TomNisbet/nqsap/docs/support/10-in-summary.md

---
title: "NQSAP and 6502 Instructions"
permalink: /docs/in-summary/
excerpt: "Instruction set summary for the NQSAP Computer"
---

## Instructions Common to 6502 and NQSAP

|Name|Description|Flags|
|:---|:---|:---:|
|[ADC](../in-details#ADC)|Add with Carry|CZVN|
|[AND](../in-details#AND)|Logical AND|-Z-N|
|[ASL](../in-details#ASL)<sub>1</sub>|Arithmetic Shift Left|CZ-N|
|[BCC](../in-details#BCC)|Branch if Carry Clear|----|
|[BCS](../in-details#BCS)|Branch if Carry Set|----|
|[BEQ](../in-details#BEQ)|Branch if Equal|----|
|[BIT](../in-details#BIT)<sub>2</sub>|Bit Test|-Z--|
|[BMI](../in-details#BMI)<sub>3</sub>|Branch if Minus|----|
|[BNE](../in-details#BNE)|Branch if Not Equal|----|
|[BPL](../in-details#BPL)<sub>3</sub>|Branch if Positive|----|
|[BVC](../in-details#BVC)<sub>3</sub>|Branch if Overflow Clear|----|
|[BVS](../in-details#BVS)<sub>3</sub>|Branch if Overflow Set|----|
|[CLC](../in-details#CLC)<sub>3</sub>|Clear Carry|C---|
|[CLV](../in-details#CLV)<sub>3</sub>|Clear Overflow|--V-|
|[CMP](../in-details#CMP)<sub>4</sub>|Compare A|CZVN|
|[CPX](../in-details#CPX)<sub>4</sub>|Compare X|CZVN|
|[CPY](../in-details#CPY)<sub>4</sub>|Compare Y|CZVN|
|[DEC](../in-details#DEC)|Decrement Memory|-Z-N|
|[DEX](../in-details#DEX)|Decrement X|-Z-N|
|[DEY](../in-details#DEY)|Decrement Y|-Z-N|
|[EOR](../in-details#EOR)|Exclusive OR|-Z-N|
|[INC](../in-details#INC)|Increment Memory|-Z-N|
|[INX](../in-details#INX)|Increment X|-Z-N|
|[INY](../in-details#INY)|Increment Y|-Z-N|
|[JMP](../in-details#JMP)|Jump|----|
|[JSR](../in-details#JSR)|Jump to Subroutine|----|
|[LDA](../in-details#LDA)|Load A|----|
|[LDX](../in-details#LDX)|Load X|----|
|[LDY](../in-details#LDY)|Load Y|----|
|[LSR](../in-details#LSR)<sub>5</sub>|Logical Shift Right|CZ-N|
|[NOP](../in-details#NOP)|No Operation|----|
|[ORA](../in-details#ORA)|Logical Inclusive OR|-Z-N|
|[PHA](../in-details#PHA)|Push A|----|
|[PLA](../in-details#PLA)|Pull A|----|
|[ROL](../in-details#ROL)<sub>5</sub>|Rotate Left|CZ-N|
|[ROR](../in-details#ROR)<sub>5</sub>|Rotate Right|CZ-N|
|[RTS](../in-details#RTS)|Return from Subroutine|----|
|[SBC](../in-details#SBC)|Subtract with Carry|CZVN|
|[SEC](../in-details#SEC)|Set Carry|C---|
|[STA](../in-details#STA)|Store A|----|
|[STX](../in-details#STX)|Store X|----|
|[STY](../in-details#STY)|Store Y|----|
|[TAX](../in-details#TAX)|Transfer A to X|----|
|[TAY](../in-details#TAY)|Transfer A to Y|----|
|[TSX](../in-details#TSX)|Transfer SP to X|----|
|[TXA](../in-details#TXA)|Transfer X to A|----|
|[TXS](../in-details#TXS)|Transfer X to SP|----|
|[TYA](../in-details#TYA)|Transfer Y to A|----|

**Notes:**
1. Does not set C flag.  Will be fixed in flags redesign
1. Does not set V and N flags
1. Requires V and N flags and ability to update, set, and clear individual flags. Redesign in progress to replace flags register with D flip-flops
1. Need to share ALU opcode with the SBC operation.  Redesign in progress to override IR and force ALU into subtract mode
1. Requires new A register hardware
## 6502 Instructions Not Implemented in NQSAP

|Name|Description|Flags|
|:---|:---|:---:|
|[BRK](../in-details#BRK)<sub>1</sub>|Force Interrupt|----|
|[CLD](../in-details#CLD)<sub>2</sub>|Clear Decimal Mode|----|
|[CLI](../in-details#CLI)<sub>1</sub>|Clear Interrupt Disable|----|
|[PHP](../in-details#PHP)<sub>3</sub>|Push Processor Status|----|
|[PLP](../in-details#PLP)<sub>3</sub>|Pull Processor Status|----|
|[RTI](../in-details#RTI)<sub>1</sub>|Return from Interrupt|----|
|[SED](../in-details#SED)<sub>2</sub>|Set Decimal Mode|----|
|[SEI](../in-details#SEI)<sub>1</sub>|Set interrupt Disable|----|

**Notes:**
1. No support for interrupts
1. No support for decimal mode
1. Flags register does not have access to the bus
## NQSAP Extensions

|Name|Description|Flags|
|:---|:---|:---:|
|[DEA](../in-details#DEA)|Decrement A|-Z-N|
|[HLT](../in-details#HLT)|Halt|----|
|[INA](../in-details#INA)|Increment A|-Z-N|
|[JCC](../in-details#JCC)|Jump if Carry Clear|----|
|[JCS](../in-details#JCS)|Jump if Carry Set|----|
|[JEQ](../in-details#JEQ)|Jump if Equal|----|
|[JMI](../in-details#JMI)|Jump if Minus|----|
|[JNE](../in-details#JNE)|Jump if Not Equal|----|
|[JPL](../in-details#JPL)|Jump if Positive|----|
|[JVC](../in-details#JVC)|Jump if Overflow Clear|----|
|[JVS](../in-details#JVS)|Jump if Overflow Set|----|
|[NOT](../in-details#NOT)|Bitwise NOT A|-Z-N|
|[OUT](../in-details#OUT)|Output A|----|

*this file was generated by nqsap-instructions.py at 22-Nov-2020 13:09:39*
