TomNisbet/nqsap/docs/assets/images/demo.gif

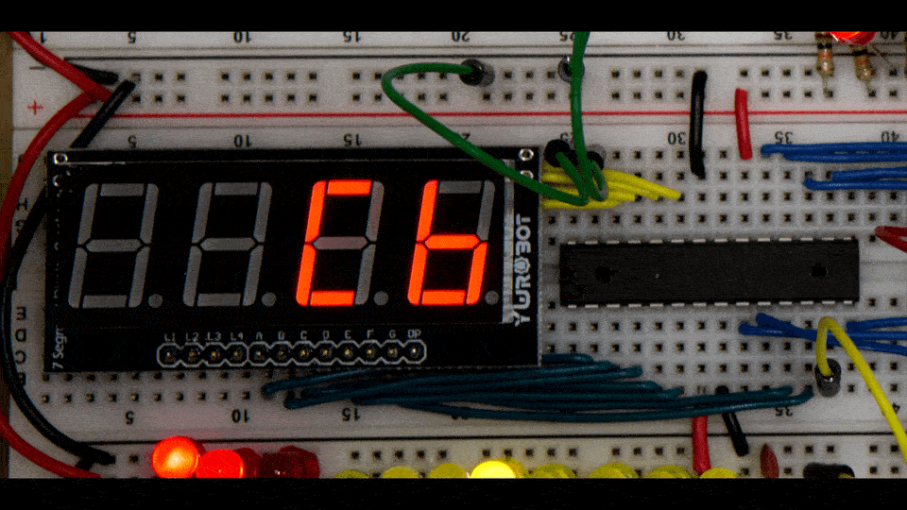
docs/assets/images/demo.gif
