TomNisbet/nqsap/docs/assets/images/digital-computer-electronics-malvino.jpg

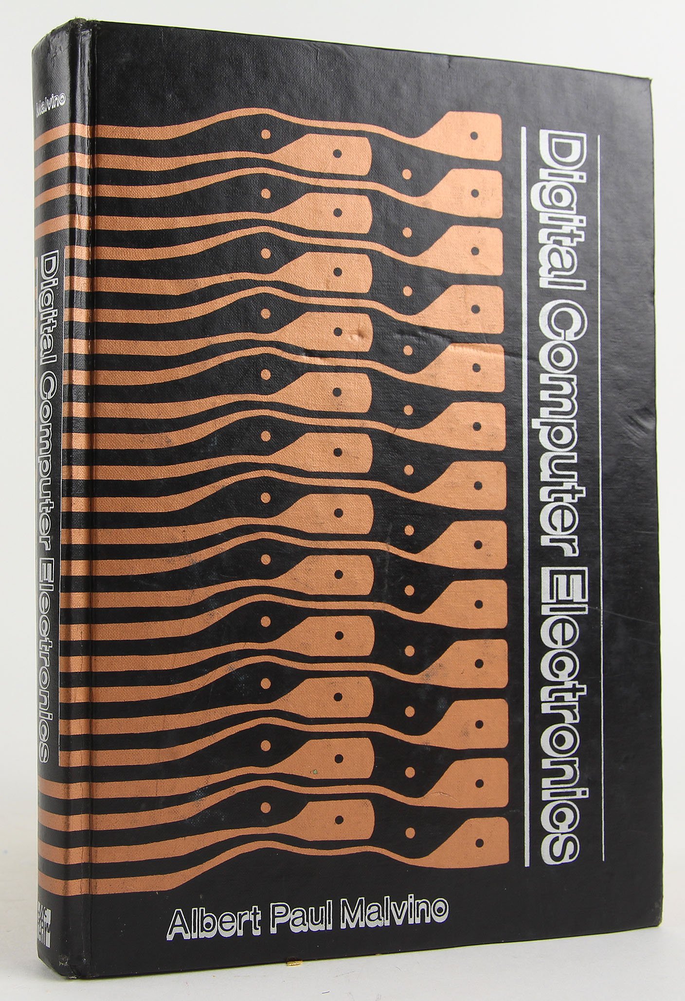
docs/assets/images/digital-computer-electronics-malvino.jpg
