TomNisbet/nqsap/docs/assets/images/empty-space.jpg

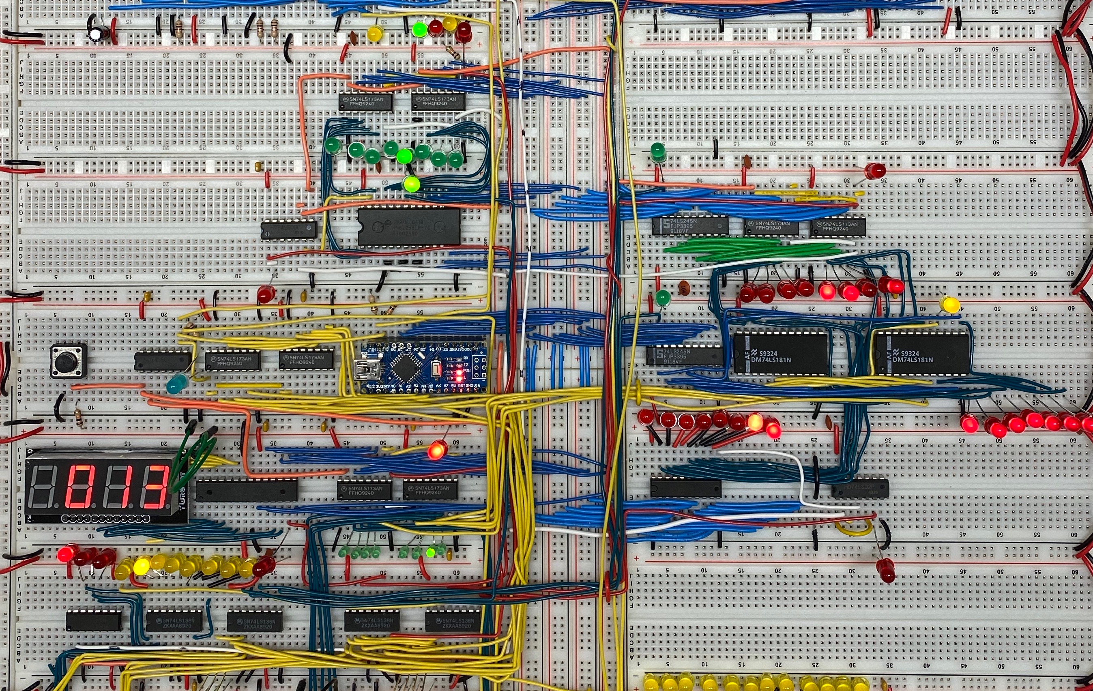
docs/assets/images/empty-space.jpg
