TomNisbet/nqsap/docs/assets/images/output.jpg

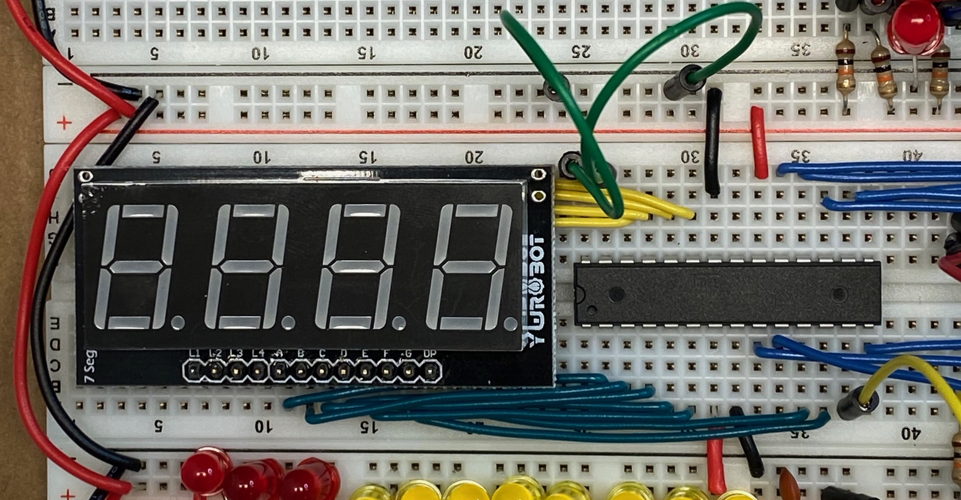
docs/assets/images/output.jpg
