TomNisbet/nqsap/docs/assets/videos/nqsap-video.png

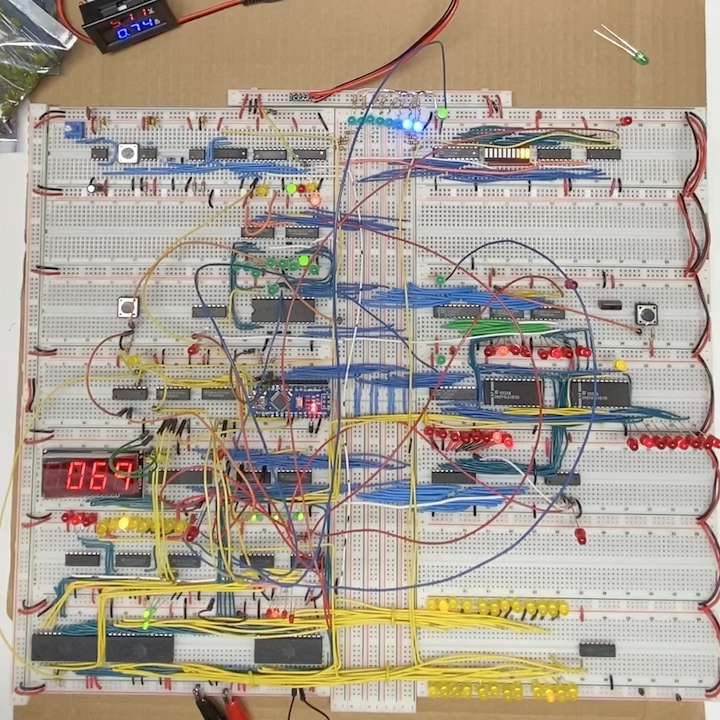
docs/assets/videos/nqsap-video.png
