TomNisbet/nqsap/docs/_docs/build-03-registers.md

---
title: "Registers"
permalink: /docs/registers/
excerpt: "Building the general purpose registers of the NQSAP computer"
---

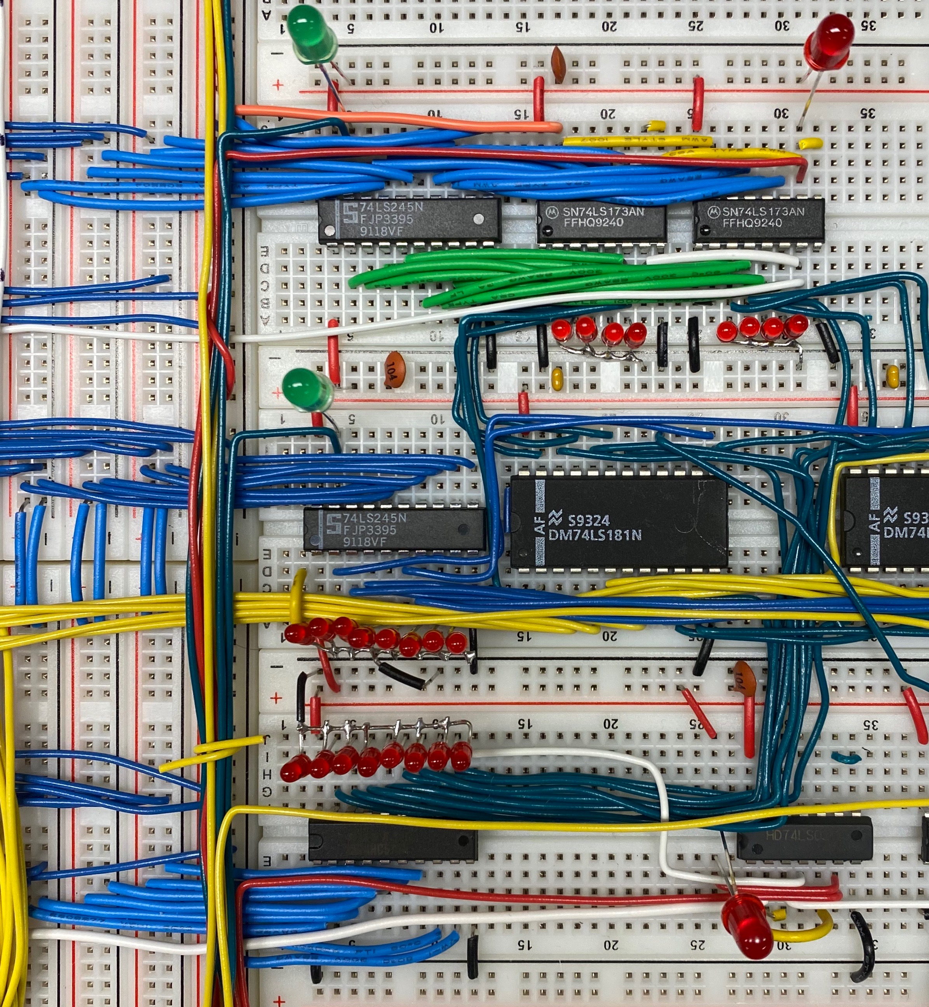
[picture p19: docs/assets/images/registers-2.jpg]
Register Implementation A and B registers


The initial build had only an A register and a B register.  These two provide the inputs
to the ALU. The A register is the accumulator, storing the result of ALU operations.  It
can be read and written with a variety of load and store instructions and its value can be
sent to the output display.

## H Register and Accumulator

The A register was initially built using the standard pair of 74LS173 4-bit registers plus
a 74LS245 bus transceiver. In a later build, the ALU's A register was replaced with a pair
of 74LS194 4-bit universal shift registers.  These provided the same basic register
operation of the 173's, but added shift capabilities to enable the LSR, ROL, and ROT
instructions.

The shift register has two control lines that select parallel load, shift left, shift
right, or no-operation.  These are wired to the ROM and labelled HR and HL.  The carry-in
value to the shift registers can come from the carry flag register or it can be forced to
zero using the CC control signal.  Note that the CC and CS carry force signals are shown
on the Flags schematic using the old notations of LC and LS.

When the shift register was added. the ALU-A and accumulator functions were split into two
registers.  The shift register connected to the ALU A inputs is now labelled as H (sHift
register). A separate A register, the user-accessible accumulator, was added using a
74HCT574 8-bit register and a 74HCT245 bus transceiver.  The A register is not connected
to the ALU and does not need to be physically near the ALU chips.  It is on the same board
as the RAM chip because there was free space available at that spot.

The H register's write operation is not controlled by the usual memory select circuit, so
it can be written at the same time as any other register.   The HL and HR lines can also
be controlled by the Loader, allowing a self test of H.  The test includes the usual
register read/write and also verifies the shift functionality.

By convention, the microcode always writes H whenever it writes A, so H will always have
the same value as A at the start of a new instruction.  The microcode is free to use H
independently, but it must be restored from A at the end of the instruction.

The independent A and H registers allow memory instructions to use the H register without
disturbing the accumulator.  For example, the AB_ROR instruction can fetch a value from
memory directly into H, shift it right, and then write it back out to memory without
disturbing the contents of the A register.  Even with this optimization, there are still
some instructions that could not be implemented using the maximum of eight
microinstructions per instruction.  Some indexed memory instructions, like AX_ROR, would
require nine microinstruction steps.

The next revision of the NQSAP computer,
[NQSAP-PCB](https://tomnisbet.github.io/nqsap-pcb/docs/ab-registers/), does away with the
shift register and uses a much simpler implementation for right shift.  On NQSAP-PCB, the
right shift operation is accomplished using a second bus transceiver wired to the B
register and offset by one bit position.  This wires bit B7 to Bus6, B6 to Bus5 and so on.
The left shift is implemented using the ALU's built-in A+A operator.  The NQSAP-PCB also
expanded the step counter to four bits, allowing sixteen microinstruction steps.

## B Register

Rather that the 74173 pair, the B register was implemented using a single 74HCT574 8-bit
register. The thought was that this could save board space and simplify the wiring.  The
wiring was easier because the chip has all of the inputs on one side and the outputs on
the other, much like the 74245 bus transceivers that are used everywhere.  In addition,
this chip had the outputs on the top of the chip, which meant that they were easier to
connect to the ALU.

In the original build, the B register was write-only and the ALU result was read-only, so
they shared a register address.  The B register is not a general-purpose register and is
not directly accessible to the user, so this seemed sufficient and it saved the need for
an additional 74LS245 bus transceiver.  There was a hack to read the B register using an
ALU operation that returns B.  This turned out to be useful as a temporary register for
the microcode so, during rewiring to add new features, an additional 245 was added to
allow direct access to the B register.

### 74574 Write Signal

Unlike the 74173, the 74574 lacks a gated input to control the loading of data so it needs
to get a clock pulse only when it is selected for writing.  In theory, this is simple
enough to do - the write signal for the register can be ANDed with the system clock to
provide a write pulse at the correct time.  This is complicated by the fact that the write
signals from the register select logic are active low instead of active high.  Rather than
using an inverter chip on the write signal and another chip for the AND operation, a quad
2-input NOR chip is used to provide the clock.  The diagram below shows the signals.

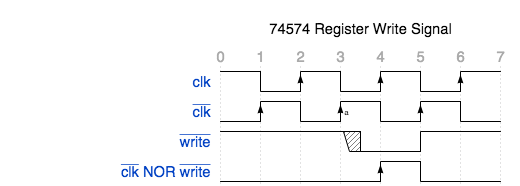
[picture p20: docs/assets/images/74574-write.png]
74574 write signals 74574 register write signals


At point "a" in the diagram, the rising edge of the inverted clock is incrementing the
ring counter to load the next microcode word that wants to write to the B register.  There
is a short period of time where the outputs of the EEPROM are in an unknown state and then
the write signal is asserted low. This signal will remain low until the next rising edge
of the inverted clock.  When the inverted clock goes low again, the NOR gate will have a
low signal at both of its inputs and will generate the clock pulse needed to load the
register.  Note that the inverted clock signal is already present on the board for the
Ring Counter, so this signal can be used as input the the B register NOR gate or one of
the unused gates can be used as an inverter for the readily available non-inverted clock
signal.

## Register Layout

One thing that needed to be considered for the B register design was the spacing required
for the 8 status LEDs that go with each register.  With the two-chip 74173 layout, the
LEDs are easy to place. The compact layout of the single 8-bit register, plus all of the
wiring to the ALU and bus, requires a bit more planning.

The initial build used 5mm LEDs, placed to the side of the chip.  The single chip plus the
LEDs ended up using as much space or more than the 4-bit, two-chip solution.  These large
LEDs were later replaced with a block of 3mm LEDs that were soldered together to minimize
the number of connections to the ground bus.  This was able to be placed directly on the
register outputs.  Note that these LEDs have
[built-in resistors](../getting-started/#5v-leds), so they can be connected directly from
the chip output to ground with no worries.

## Bill of Materials

* 74LS02 quad 2-input NOR gate (1)
* 74LS194 4-bit universal shift register (2)
* 74HCT245 8-bit bus transceiver (2)
* 74HCT574 8-bit register (1)
