TomNisbet/nqsap/docs/assets/images/disassembled.jpg

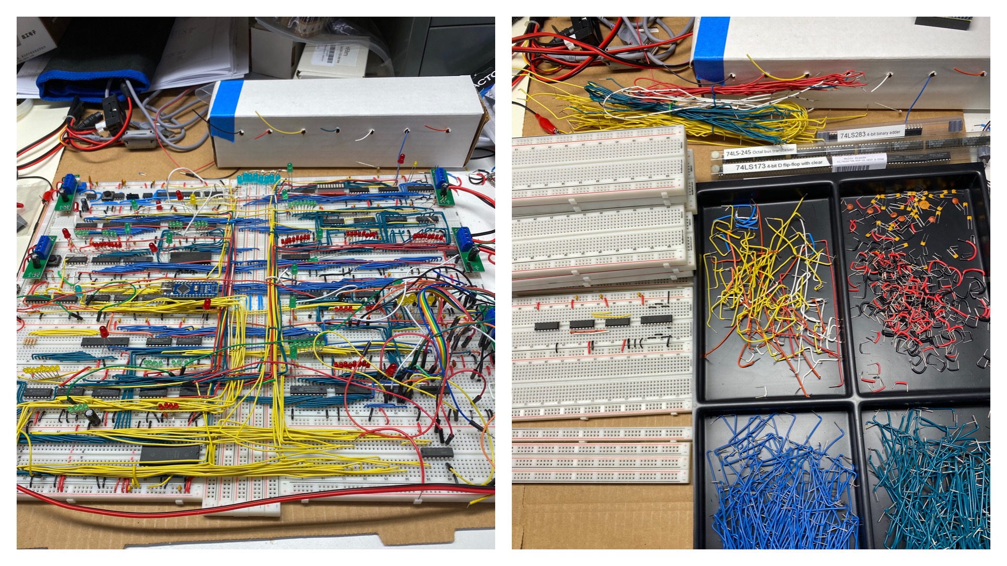
docs/assets/images/disassembled.jpg
