TomNisbet/nqsap/docs/assets/images/dxy-build.jpg

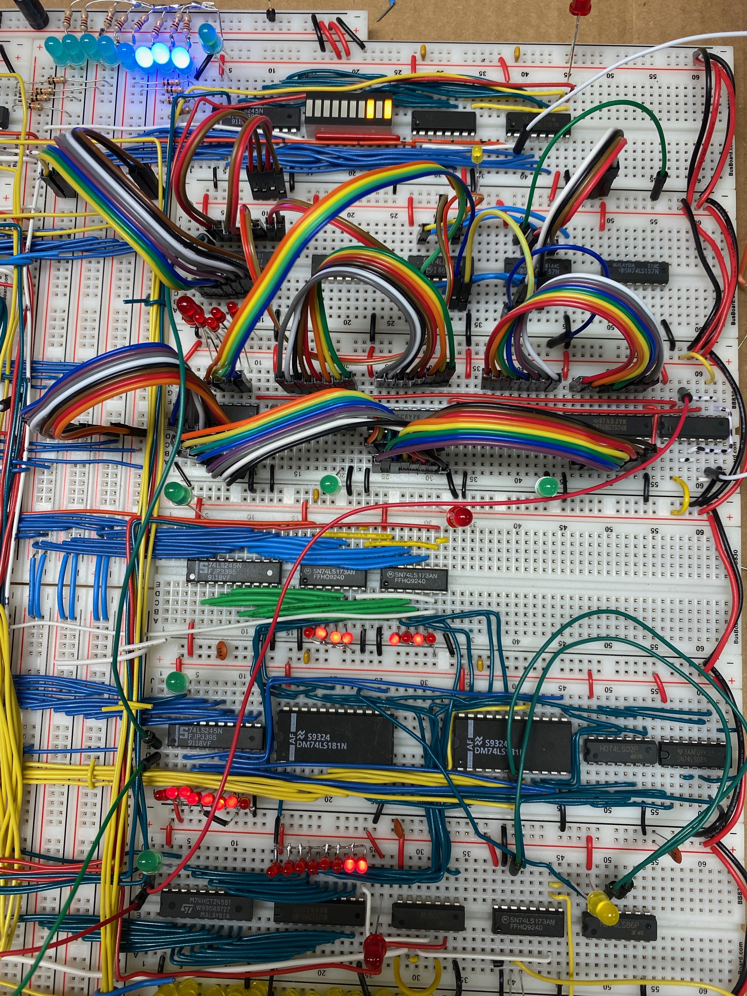
docs/assets/images/dxy-build.jpg
