TomNisbet/nqsap/docs/assets/videos/self-test.png

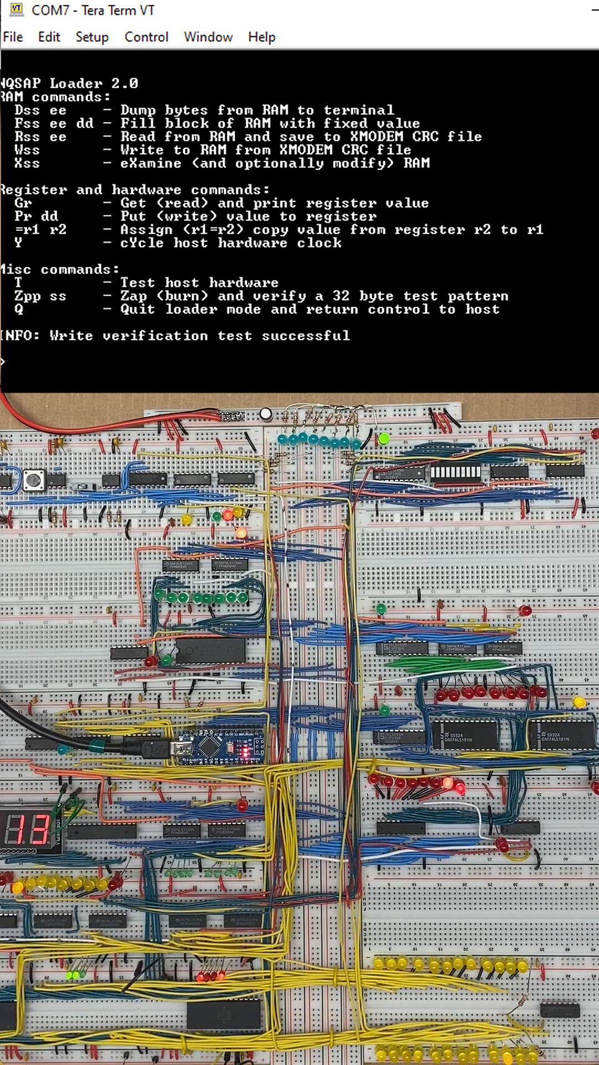
docs/assets/videos/self-test.png
