TomNisbet/nqsap/NQSAP schematics/NQSAP schematics.kicad_pcb

## KiCad design schematics/oled-display-schematic.sch


Parts:
J1: Left rail ESP32 devkit v1
J2: Right rail ESP32 devkit v1
J3: PCD8544 display
R1: 5.6k
RV1: 10k
SW1: NO

Connections:
+3.3V: J3.6
+3V3: J2.1
CE: J2.4, J3.2
CLK: J2.9, J3.5
DC: J2.5, J3.3
DIN: J2.18, J3.4
GNDREF: J2.2, J3.8, R1.1, SW1.2
GPIO21: J2.14, SW1.1
GPIO22: J2.17, J3.1
LIGHT: J3.7, RV1.1
unnamed: R1.2, RV1.3
