TomNisbet/nqsap/(commit log)

2020-07-21 add READMEs for the Arduino sketches
2020-07-28 Fix microcode errors in conditional jumps and memory vs immediate istructions
    [LoaderHw.cpp, arduino-loader.ino, arduino-microcode.ino]
2020-08-20 Add LED photo
2020-08-20 soldered LEDs documentation
2020-10-07 Add Stack Pointer. Increase delay for readRegister to allow bus to stabilize.
    [LoaderHw.cpp, arduino-loader.ino]
2020-10-11 Initial Stack Pointer support. Fix block mode writes for microcode burner.
    [arduino-loader.ino, arduino-microcode.ino]
2020-10-19 Fix RTS instruction; add stack test program to loader
    [arduino-loader.ino, arduino-microcode.ino]
2020-10-26 Fix ALU register definition in Loader
    [LoaderHw.cpp]
2020-11-23 Add DXT registers and many new instructions and address modes
    [in-general.csv, in-specific.csv]
2020-11-24 More details added to instruction set documentation
    [in-specific.csv]
2020-12-02 Cleanup instruction set docs
    [in-general.csv, in-specific.csv]
2020-12-02 Remove HLT instruction and control line. Add names command and reset control to Loader.
    [LoaderHw.cpp, LoaderHw.h, arduino-loader.ino, arduino-microcode.ino]
2020-12-13 Shift register implementation
    [in-specific.csv]
2021-03-21 Re-arrange instruction set for new flags support
    [in-general.csv, in-specific.csv]
2021-03-25 flags doc cleanup
    [in-general.csv, in-specific.csv]
2021-03-25 enlarge carry-out schematic
2021-04-13 add schematics for the Loader and the uCode ROMs
2021-04-15 links to schematics
2021-04-17 add ALU schematic
2021-04-18 add schematics for DXY registers
    [NQSAP schematics.kicad_pcb, NQSAP schematics.sch, alu-registers.sch, clock-control.sch, control-roms.sch, dxy-registers.sch, flags.sch, loader-debugger.sch]
2021-04-24 fix duplicate part numbers on dxy schematic
    [NQSAP schematics.sch, alu-registers.sch, clock-control.sch, control-roms.sch, dxy-registers.sch, flags.sch, loader-debugger.sch]
2022-07-26 Link to NQSAP-PCB project
2022-09-29 docs updates flags link to NQSAP-PCB
2022-10-17 ALU and register documentation fixes from u/andreamazzai69
    [arduino-microcode.ino]
2024-09-06 add reference to NQSAP-PCB Loader in docs
